schmidjon/door-sign/case/button-hole-test.stl

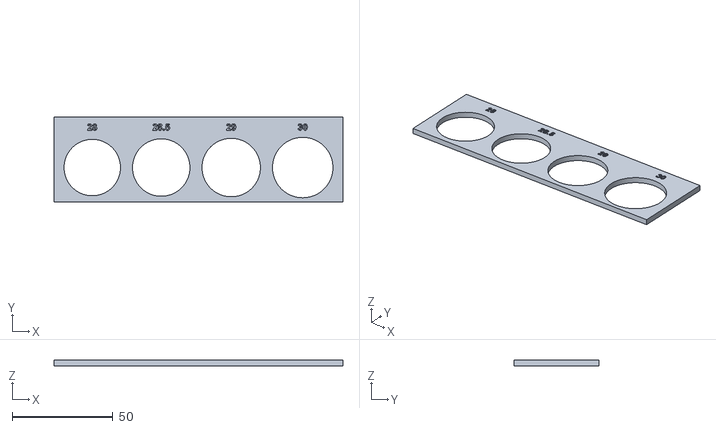
[picture p4: CAD file, 2026-11-11]
case/button-hole-test.stl
143.5 x 42.0 x 2.80
