schmidjon/door-sign/case/case-top-print-this-way-up.stl

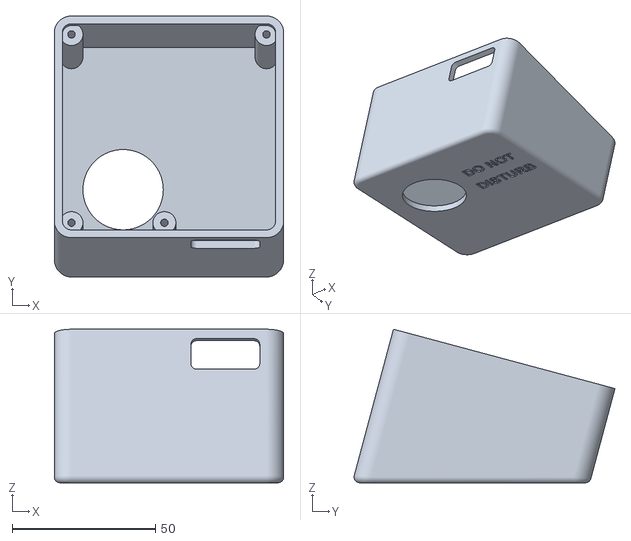
[picture p5: CAD file, 2026-11-11]
case/case-top-print-this-way-up.stl
80.0 x 91.0 x 53.5
