schmidjon/door-sign/case/case-top.step

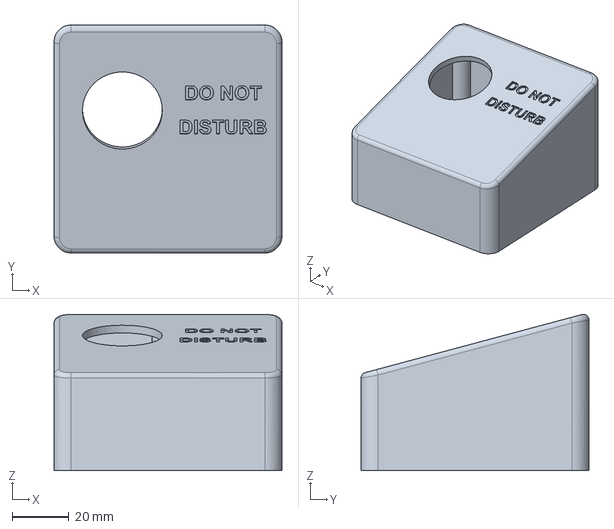
[picture p6: CAD file, 2026-11-11]
case/case-top.step
80.0 x 80.0 x 54.8 mm
