schmidjon/door-sign/case/case-base.step

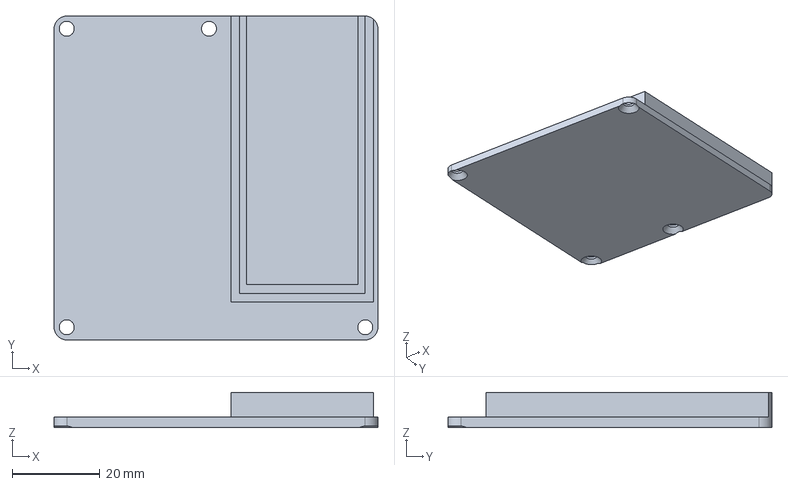
[picture p7: CAD file, 2026-11-11]
case/case-base.step
73.8 x 73.8 x 8.00 mm
