schmidjon/door-sign/(list of files, cad)

Other CAD files:
case/case-base.stl
